chenxuuu/BT-MP3/(commit log)

2025-02-03 add: 先摆几个元器件
    [bt-mp3.kicad_pcb, bt-mp3.kicad_sch]
2025-02-05 add: 基础的外围器件
    [bt-mp3.kicad_sch]
2025-02-06 update: 完成原理图
    [bt-mp3.kicad_sch]
2025-02-06 add: 原理图信息
    [bt-mp3.kicad_sch]
2025-02-10 update: 分配好封装
    [bt-mp3.kicad_sch]
2025-02-10 add: 布线
    [bt-mp3.kicad_pcb, bt-mp3.kicad_sch]
